hredan/SleepUino/SleepUino/README.md

SleepUino DIY Alarm-Clock with webinterface
# SleepUino Arduino Sketch
This folder contains the Arduino Sketch files.

## ESP8266 Board Package
Link to the ESP8266 Board Package: [http://arduino.esp8266.com/stable/package_esp8266com_index.json](http://arduino.esp8266.com/stable/package_esp8266com_index.json)

Last used version: 3.0.2

## Needed Libraries to build SleepUino
Before you can build the SleepUino successfully, you have to install some Libraries with the Arduino Library Manager. In the follwing table you can find the Libraries, a link to the webside, the last version I have used for a succsessfull build.
| Name of Lib | Version
| --- | --- |
| [ArduinoJson](https://arduinojson.org/)  |  6.19.3 |
| [ESP8266Audio](https://github.com/earlephilhower/ESP8266Audio)  | 1.9.5  |
| [JC_Button](https://github.com/JChristensen/JC_Button) | 2.1.2 |
| [RTClib by Adafruit](https://github.com/adafruit/RTClib) | 2.0.2 |
| [U8g2](https://github.com/olikraus/u8g2) | 2.31.2 |
