hredan/SleepUino/CircuitDiagram/SleepUino_ESP_D1_Mini_CircuitDiagram.pdf

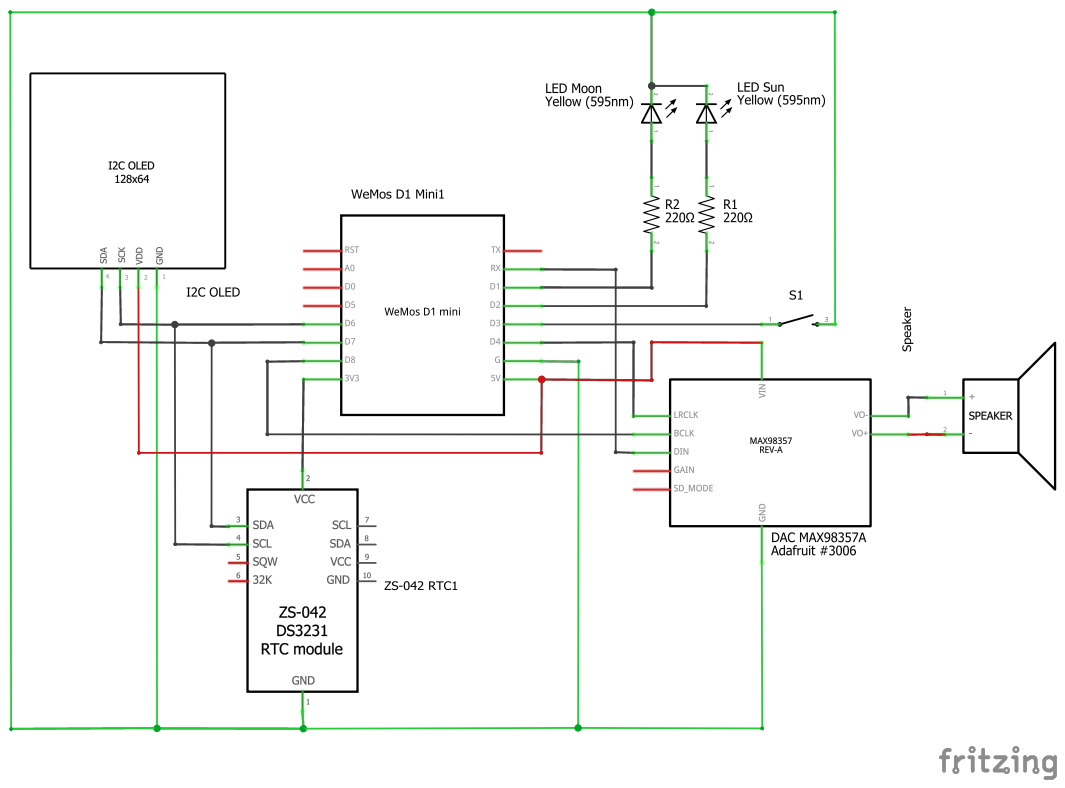
[picture p9: page 1]
