hredan/SleepUino/CircuitDiagram/SleepUino_ESP_D1_Mini_MiniBreadboard.pdf

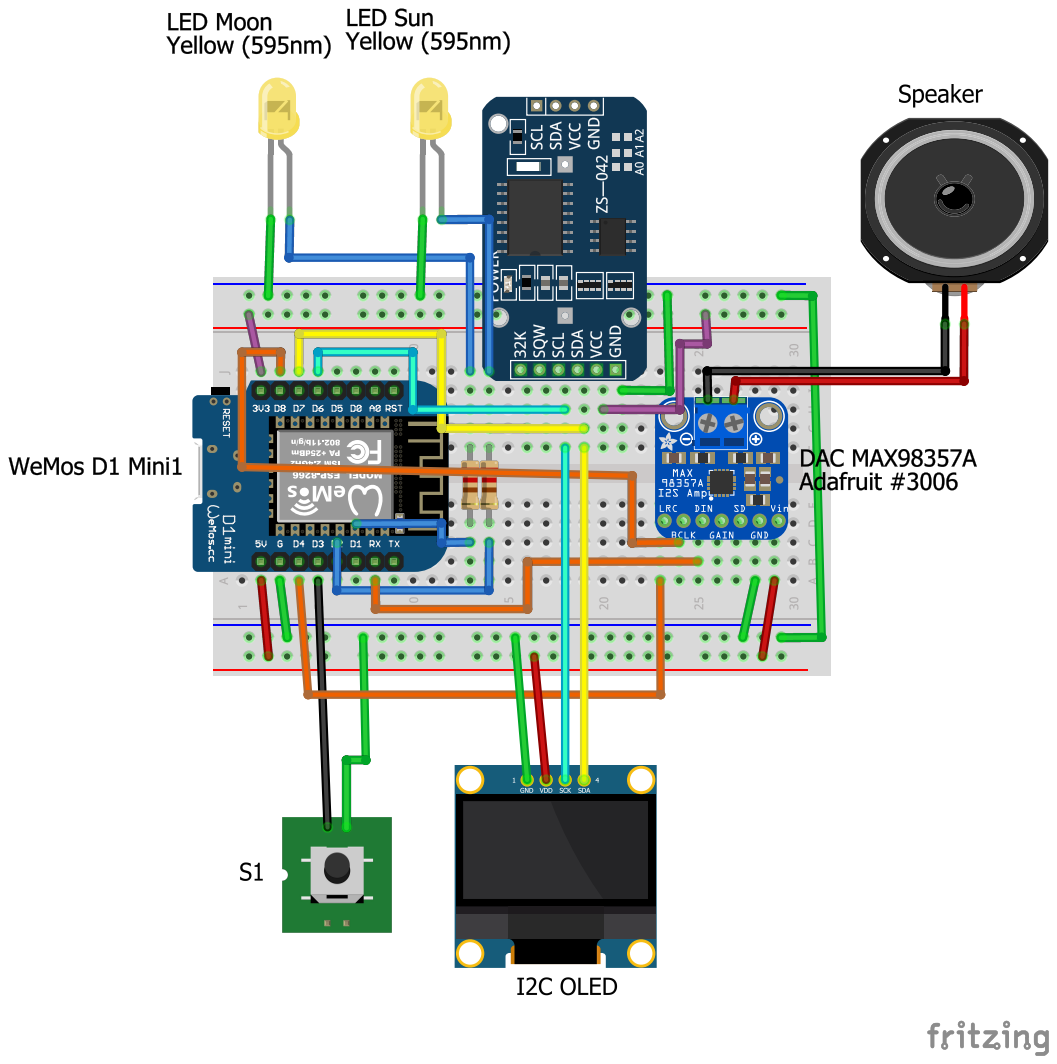
[picture p10: page 1]
