hredan/SleepUino/CircuitDiagram/SleepUino_ESP_NodeMCU_V3_Breadboard.pdf

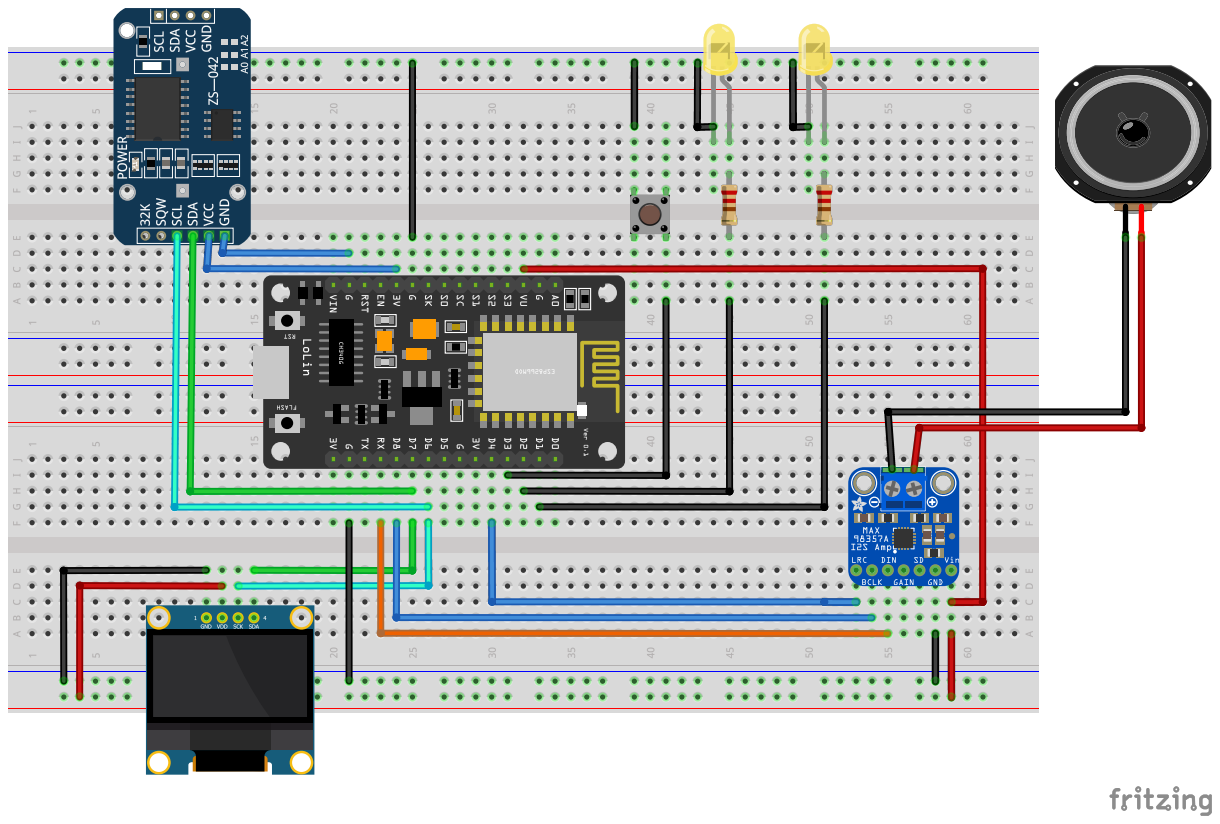
[picture p11: page 1]
