hredan/SleepUino/CircuitDiagram/SleepUino_ESP_NodeMCU_V3_CircuitDiagram.pdf

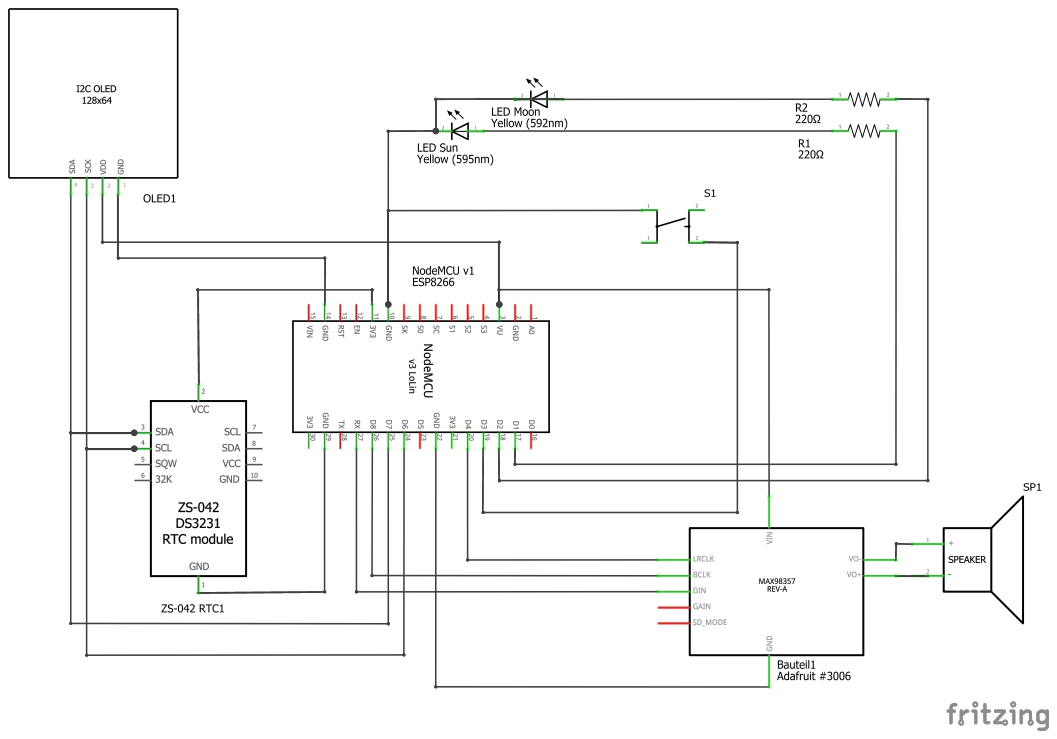
[picture p12: page 1]
