hredan/SleepUino/(commit log)

2021-02-16 add Circuit Diagrams (Hardware needed to use SleepUino)
2021-02-17 1. bugfix: after renaming of sound sample file, add logging for missing file 2. fine tuning of max gain sound
    [handleAudio.ino]
2021-02-17 save current status
2021-02-19 add circuit images and links to README.md
2021-02-22 add image and text for Plywood Housing
2021-02-22 add image of Garbage Collection Housing
2021-02-24 add images for Housing called "Garbage Collection"
2022-03-30 change AlarmSound from 8bit to 16bit Changes to use the actual packages: RTCLib 2.0.2 JC_Button 2.1.2 ESP8266Audio 1.9.5 ArduinoJson 6.19.3 U8g2 2.31.2
2022-04-04 add test-switch
2022-04-05 add Test-Switch dynamic
2022-04-09 add Testtab dynamically by Test Switch
2022-05-01 fixing compiler warinings, add more error handling
    [handleDisplay.ino, handleWebpage.h, handleWebpage.ino, mainFunctionality.h, mainFunctionality.ino]
2026-04-27 Fix cpplint errors: Add missing includes and use static_cast
    - Include <cstdio> in handleDisplay, handleWebpage, and mainFunctionality
    - Replace C-style cast with static_cast in handleEeprom
    - Add .venv to .gitignore
    update actions to latest versions
    pipline: add latest stable python version
    [handleDisplay.ino, handleEeprom.ino, handleWebpage.ino, mainFunctionality.ino]
2026-08-26 fix dimming led issue
    [mainFunctionality.ino]
2026-09-07 AlarmSound change Samplerate to 44100 Hz to fix issue 20
2026-09-14 Stop Button und Übersetzungen hinzufügen
2026-09-14 add default sound and sound reset button
2026-09-18 Prevents the alarm sound from playing again while it is currently playing
    [handleAudio.ino]
2026-09-21 add i2c dac test
